usbharu/HomeCockpit/firmware/upper_panel_ddi/README.md

# upper_panel_ddi firmware

`upper_panel_ddi` は Upper Panel DDI 向けのファームウェアです。Cargo feature で MCU を選びます。

| Feature（default） | MCU | Rust target |
| --- | --- | --- |
| `rp2040`（default） | RP2040（Pico など） | `thumbv6m-none-eabi` |
| `rp235x` | RP235x（Pico 2 など） | `thumbv8m.main-none-eabihf` |

Cargo のデバッグ runner には `probe-rs run` を使用します。`.cargo/config.toml` で target ごとに chip を切り替えています。

## 必要なツール

- Rust toolchain
- 対象 MCU に応じた Rust target（RP2040: `thumbv6m-none-eabi`、RP235x: `thumbv8m.main-none-eabihf`）
- `probe-rs`（`probe-rs-tools`）
- 対象ボードに接続した SWD 対応の Debug Probe

`probe-rs` は [公式インストール手順](https://probe.rs/docs/getting-started/installation/)
に従ってインストールし、`probe-rs` コマンドが `PATH` に含まれていることを確認してください。

```powershell
rustup target add thumbv6m-none-eabi
rustup target add thumbv8m.main-none-eabihf
probe-rs --version
```

## Probe とターゲットの確認

RP2040:

```powershell
probe-rs list
probe-rs info --chip RP2040 --protocol swd
```

RP235x:

```powershell
probe-rs list
probe-rs info --chip RP235x --protocol swd
```

`probe-rs list` に Debug Probe が表示され、`probe-rs info` が対象 chip に接続できれば、
書き込みの準備は完了です。複数の Probe を接続している場合は、必要に応じて
`--probe VID:PID[:SERIAL]` をコマンドへ追加してください。runner の設定には特定の
Probe ID を固定していません。

## ビルドと実行

### RP2040（default）

```powershell
cd C:\Users\haruj\Documents\HomeCockpit\firmware\upper_panel_ddi
cargo build --locked --bin upper_panel_ddi
cargo run --locked --bin upper_panel_ddi
```

`.cargo/config.toml` の `thumbv6m-none-eabi` runner は `probe-rs run --chip RP2040` です。

### RP235x

default feature を外し、`rp235x` と target を明示します。

```powershell
cd C:\Users\haruj\Documents\HomeCockpit\firmware\upper_panel_ddi
cargo build --locked --no-default-features --features rp235x --target thumbv8m.main-none-eabihf --bin upper_panel_ddi
cargo run --locked --no-default-features --features rp235x --target thumbv8m.main-none-eabihf --bin upper_panel_ddi
```

`thumbv8m.main-none-eabihf` の runner は `probe-rs run --chip RP235x`（`--protocol swd --connect-under-reset`）です。

`cargo run` は `probe-rs run` によってファームウェアを書き込み、ターゲットを
リセットして実行します。`defmt-rtt` の RTT/defmt ログは同じコンソールへ出力されます。
ログレベルは `.cargo/config.toml` の `DEFMT_LOG = "debug"` で設定されています。

## panic と HardFault の診断

`panic-probe` と `defmt-rtt` をリンクしているため、panic 発生時の情報は
`probe-rs run` のコンソールで確認できます。HardFault の診断時は、ビルド済み ELF を
直接実行してスタックトレースを常に表示できます。

```powershell
probe-rs run --chip RP2040 --always-print-stacktrace `
  target\thumbv6m-none-eabi\debug\upper_panel_ddi
```

通常の開発では `cargo run --locked --bin upper_panel_ddi` を使用してください。

## IMCP 通信の確認

この crate は USB CDC 接続中は USB CDC（Windows では COM ポート）を、USB CDC が
接続されていない場合は UART を IMCP transport として使用します。どちらも
115200 baud の IMCP 通信です。ファームウェア実行後、既存の IMCP ホストを接続して、
次の動作を確認します。

1. デバイスから JOIN が送信される。
2. アドレス割り当てを受信する。
3. ACK が返る。
4. ボタン操作で制御イベントが送信される。
5. USB CDC または UART 経由の通信が継続する。

Manager などのホストから HCP の `RequestDeviceHello` を受信した場合、デバイスは
現在の IMCP address から `DeviceHello` を再送します。これにより、デバイスが既に
`Ready` 状態で起動した Manager に接続された場合も再発見できます。
表示 Data の適用とこの再送は、送信元が IMCP マスター `0x01` のフレームだけです。
直接接続には送信元を書き換えるハブがないためです。
送信キューには ACK と `DeviceHello` 用の 2 枠を予約しており、通常のボタンイベントが
この予約枠を消費しないようにしています。Manager 側も取りこぼしに備え、100ms 間隔で
最大 4 回（初回を含む）`RequestDeviceHello` を送信します。

## Hardening の再現可能な検証

受信経路には、IMCP の最大フレームを考慮した固定長バッファ、同一 read に含まれる複数
フレームの drain、受信バッファ溢れ後の SOF 再同期、再接続時の送信キュー破棄を実装して
います。ACK/Pong は専用の 2 スロットの送信キューから優先送信します。通常の button
event は、`DeviceHello` 用の 2 スロットをアプリケーション送信キューに残して追加します。
USB write endpoint の異常時は UART へフォールバックし、実際の USB 切断を確認してから
USB への再接続を試みます。

ホスト側の IMCP 回帰テストとフォーマットは次で確認できます。

```powershell
cd C:\Users\haruj\Documents\HomeCockpit\imcp
cargo test --locked --workspace
cargo fmt --all -- --check
cargo clippy --locked --workspace --lib --bins -- -D warnings
```

ファームウェアの CI と同じ検証は、サブモジュールを初期化したチェックアウトで次を実行
します。

```powershell
cd C:\Users\haruj\Documents\HomeCockpit\firmware\upper_panel_ddi
cargo build --locked --release --target thumbv6m-none-eabi --bin upper_panel_ddi
cargo fmt --all -- --check
cargo clippy --locked --target thumbv6m-none-eabi --bin upper_panel_ddi -- -D warnings
```

RP235x（CI と同じコマンド）:

```powershell
$env:RUSTFLAGS = '-C target-cpu=cortex-m33'
cargo build --locked --release --no-default-features --features rp235x --target thumbv8m.main-none-eabihf --bin upper_panel_ddi
cargo clippy --locked --no-default-features --features rp235x --target thumbv8m.main-none-eabihf --bin upper_panel_ddi -- -D warnings
```

stack watermark はまだ導入していないため、実行時の watermark を確認済みとは扱いません。
代わりに release ELF の linker map を生成して、静的 RAM 使用量と linker が予約する stack
領域を確認できます。

```powershell
$env:RUSTC_WRAPPER = ''
$env:RUSTFLAGS = '-C link-arg=-Map=C:\temp\upper_panel_ddi.map'
cargo build --locked --release --target thumbv6m-none-eabi --bin upper_panel_ddi
Select-String -Path C:\temp\upper_panel_ddi.map -Pattern '_stack_start|_stack_end|\.bss|\.data|\.uninit'
```

map の確認は stack overflow が発生しないことの証明ではありません。実機の長時間確認では、
`probe-rs run --always-print-stacktrace` の RTT/defmt 出力を採取し、USB CDC の再接続、
JOIN/SetAddress/ACK、`DeviceHello`、button event の順に観測してください。

## `probe-run` からの移行

以前の runner は `probe-run --chip RP2040` でした。`probe-run` はメンテナンスモードの
ため、現在は後継の `probe-rs run --chip RP2040` を使用します。runner では Probe ID、
接続速度、`--connect-under-reset` を固定せず、接続環境に応じた指定をコマンドラインから
追加できるようにしています。
