usbharu/HomeCockpit/upper_panel_ddi/mechanical/case/upper_panel_ddi_case.dxf

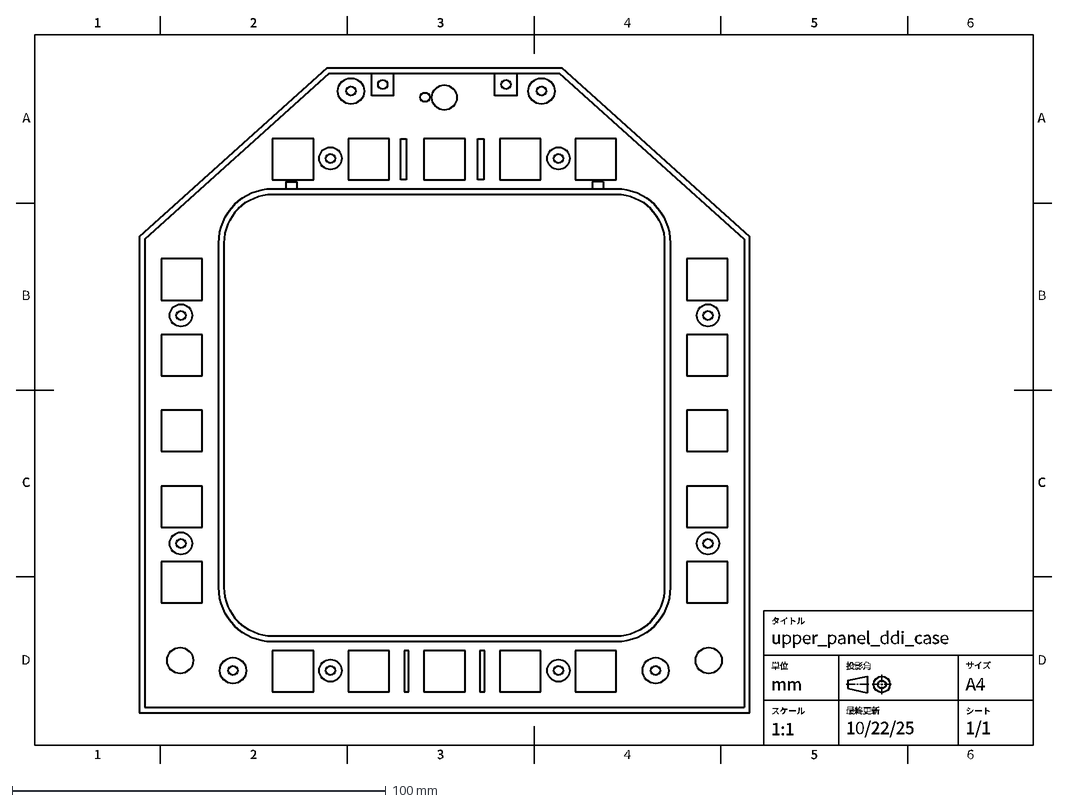
[picture p2: CAD file, 2025-10-22]
upper_panel_ddi/mechanical/case/upper_panel_ddi_case.dxf
1
2
3
4
5
6
D
C
B
A
10/22/25
タイトル
upper_panel_ddi_case
単位
mm
スケール
投影角
サイズ
A4
1:1
最終更新
シート
1/1
