usbharu/HomeCockpit/upper_panel_ddi/pcb/button_panel/upper_panel_ddi_button_panel.dxf

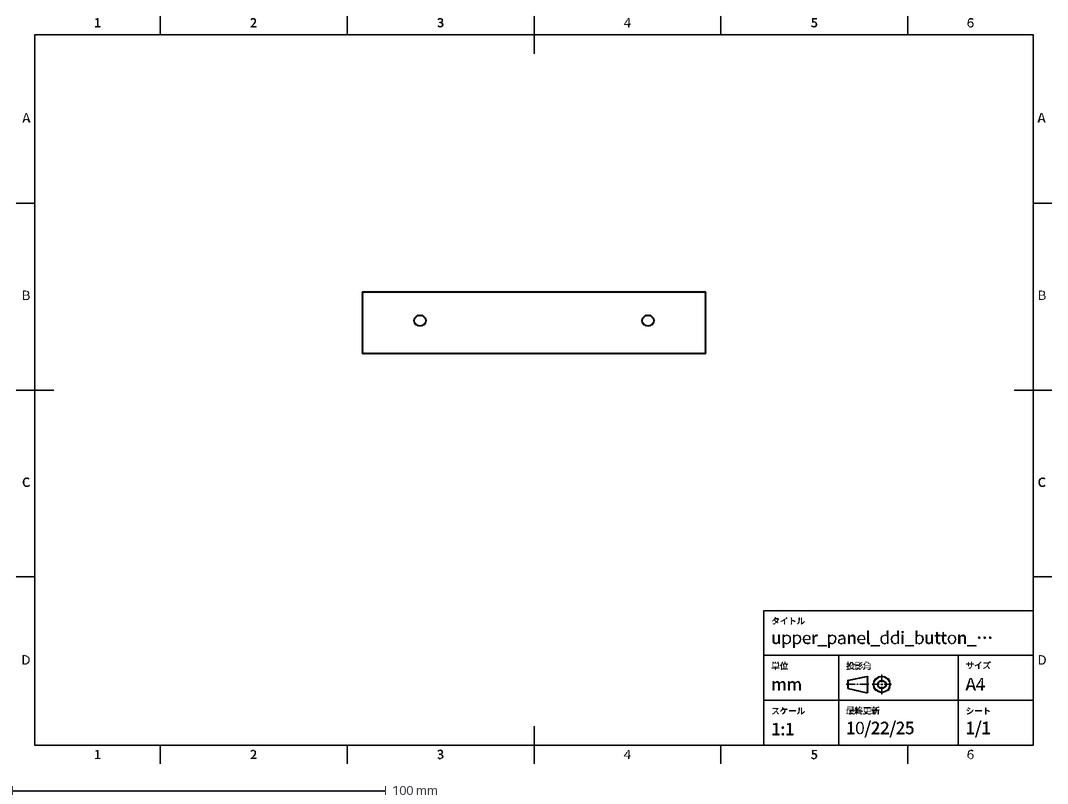
[picture p3: CAD file, 2025-10-22]
upper_panel_ddi/pcb/button_panel/upper_panel_ddi_button_panel.dxf
1
2
3
4
5
6
D
C
B
A
10/22/25
タイトル
upper_panel_ddi_button_…
単位
mm
スケール
投影角
サイズ
A4
1:1
最終更新
シート
1/1
