usbharu/HomeCockpit/upper_panel_ddi/pcb/button_panel/upper_panel_ddi_button_panel.kicad_pcb

## KiCad design upper_panel_ddi/pcb/button_panel/upper_panel_ddi_button_panel.kicad_pcb (2026-09-18)

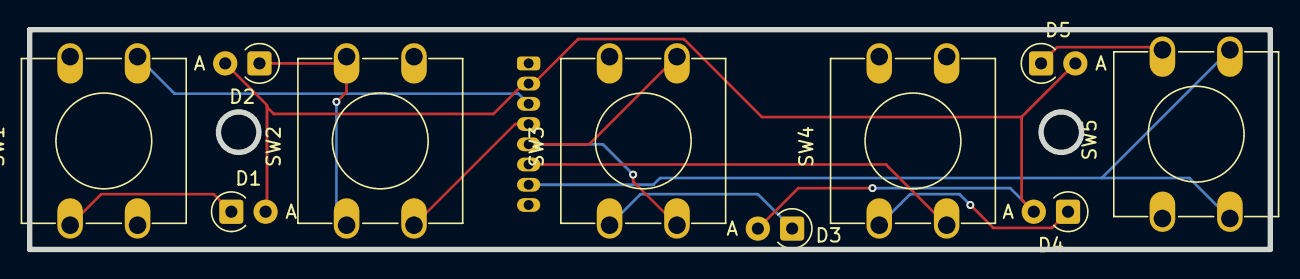
[picture p4: board upper_panel_ddi_button_panel.kicad_pcb from above]

Board: 2 copper layers, 92.0 x 16.3 mm, 11 parts (1 on the bottom side), 11 nets.

Parts:
D1, D2, D3, D4, D5: D; D_A-405_P2.54mm_Vertical_AnodeUp
J1: Conn_01x08_Pin; JST_ZH_B8B-ZR_1x08_P1.50mm_Vertical
SW1, SW2, SW3, SW4, SW5: SW_Push; SW_PUSH-12mm-mini

Connections:
unnamed: D1.2 (A), D2.2 (A), D3.2 (A), D4.2 (A), D5.2 (A), J1.2
unnamed: D1.1 (K), SW1.1
unnamed: D2.1 (K), SW2.1
unnamed: D3.1 (K), SW3.1
unnamed: D4.1 (K), SW4.1
unnamed: D5.1 (K), SW5.1
unnamed: J1.3, SW1.2
unnamed: J1.4, SW2.2
unnamed: J1.5, SW3.2
unnamed: J1.6, SW4.2
unnamed: J1.7, SW5.2
