usbharu/HomeCockpit/firmware/upper_panel_ddi/build.rs

//! This build script copies the `memory.x` file from the crate root into
//! a directory where the linker can always find it at build time.
//! For many projects this is optional, as the linker always searches the
//! project root directory -- wherever `Cargo.toml` is. However, if you
//! are using a workspace or have a more complicated build setup, this
//! build script becomes required. Additionally, by requesting that
//! Cargo re-run the build script whenever `memory.x` is changed,
//! updating `memory.x` ensures a rebuild of the application with the
//! new memory settings.

use std::env;
use std::fs::File;
use std::io::Write;
use std::path::PathBuf;

fn main() -> Result<(), Box<dyn std::error::Error>> {
    let rp235x = env::var("CARGO_FEATURE_RP235X").is_ok();
    let memory_x: &[u8] = if rp235x {
        include_bytes!("memory-rp235x.x")
    } else {
        include_bytes!("memory.x")
    };

    // Put `memory.x` in our output directory and ensure it's
    // on the linker search path.
    let out = PathBuf::from(env::var_os("OUT_DIR").ok_or("OUT_DIR is not set")?);
    File::create(out.join("memory.x")).and_then(|mut file| file.write_all(memory_x))?;
    println!("cargo:rustc-link-search={}", out.display());

    // By default, Cargo will re-run a build script whenever
    // any file in the project changes. By specifying `memory.x`
    // here, we ensure the build script is only re-run when
    // `memory.x` is changed.
    println!("cargo:rerun-if-changed=memory.x");
    println!("cargo:rerun-if-changed=memory-rp235x.x");
    println!("cargo:rerun-if-changed=build.rs");

    println!("cargo:rustc-link-arg-bins=--nmagic");
    println!("cargo:rustc-link-arg-bins=-Tlink.x");
    if !rp235x {
        println!("cargo:rustc-link-arg-bins=-Tlink-rp.x");
    }
    println!("cargo:rustc-link-arg-bins=-Tdefmt.x");

    Ok(())
}
