usbharu/HomeCockpit/(commit log)

2025-10-19 refactor(imcp): ファイルを分割
2025-10-22 kicad: upper_panel_ddi_button_panelの設計を追加
    [upper_panel_ddi_button_panel.dxf, upper_panel_ddi_button_panel.kicad_pcb, upper_panel_ddi_button_panel.kicad_sch, upper_panel_ddi_case.dxf]
2025-10-22 wip(imcp): Master/Clientを生成できるように
2025-10-23 feat(imcp): ClientでSetAddressが動作するように
2025-10-23 feat(imcp): クライアントにNotReadyの状態を追加
2025-10-23 fix(imcp): ペイロードにSOFバイトが来た際に正常に動作しない問題を修正
2025-10-23 chore: VSCodeですべてのプロジェクトを読み込むように
2025-10-23 fix(imcp): エンコード処理が抜け落ちていたので追加
2025-10-24 feat(imcp): MasterのStateを追加
2025-10-25 kicad: upper_panel_ddiを追加
    [upper_panel_ddi.kicad_pcb, upper_panel_ddi.kicad_sch]
2025-10-25 wip(firmware): 組み込み開発の構成を追加
2025-10-26 kicad: AE-RP2040のシンボルとフットプリントを追加
    [upper_panel_ddi.kicad_sch]
2025-10-30 wip(imcp): 送るFrameをキューに保持できる準備
2025-10-30 wip(imcp): embassyへの依存を切り離した
2025-10-30 feat(imcp): 送信を追加
2025-11-01 feat(imcp): embassyで動作するように
2025-11-01 chore: VSCodeのスペルチェッカーにスペルを追加
2025-11-01 feat(imcp): ログを追加
2025-11-01 feat(firmware): ddiのキーマトリクスが動作するように
2025-11-01 kicad: upper_panel_ddiを更新
    IOエキスパンダを使わずRaspberry PI Picoを直接使うように
    [upper_panel_ddi.kicad_pcb, upper_panel_ddi.kicad_sch]
2025-11-03 refactor(imcp): 危険なunwrapを無くした
2025-11-03 chore: スペルチェッカーに単語を追加
2025-11-04 feat(imcp): キャリアセンスを追加
2025-11-05 feat(imcp): defmt対応
2025-11-05 feat(firmware): imcpが動作するように
2025-11-07 feat(imcp): imcp-tokioを追加
2025-11-07 feat(utils): imcp-cliを追加
2025-11-07 feat(utils): imcp-cliにunpackとwatchを追加
    unpackは標準入力とオプションからhexを読み取り、パースして表示します。watchはシリアルポートを監視してunpackと同等の内容を実行します。
2025-11-07 fix(imcp): imcp-embeddedでバイト列が完全に送信できてない場合がある問題を修正
    write_allを使用していなかったため送信できていないデータがあった
    writeの使用箇所をwrite_allに変更して修正
    [lib.rs]
2025-11-07 fix(firmware): flushできてなかったので修正
2025-11-07 feat(utils): logを追加
2026-04-01 Add HCP firmware base and unique device identity handling
2026-04-01 Detect IMCP/HCP devices in the manager settings tab
2026-04-02 feat(manager): update IMCP device discovery to return device count and scanned ports
2026-04-02 Add dcs-bios-rs crate and fix its dependencies
    [lib.rs]
2026-04-02 Add DeviceRole-based DCS-BIOS mapping to manager
2026-09-11 fix(imcp): harden protocol framing and addressing
    [lib.rs]
2026-09-11 feat(firmware): add Pico 2 bring-up projects
2026-09-11 fix(imcp): tolerate duplicate address assignment acknowledgements
    [lib.rs]
2026-09-11 debug(firmware): log upper panel UART receive data
2026-09-12 test(imcp): add POSIX PTY wire E2E coverage (#26)
2026-09-12 Issue #28: 変更箇所に応じた並列 CI (#33)
    * ci: add path-aware GitHub Actions checks
    * test: add host smoke tests for empty test targets
    * chore(ci): fix existing CI failures
    * fix(ci): support GitHub runner native dependencies
    * ci: limit workflow to pull requests targeting master
    * ci: render KiCad violations on board images
    * fix(ci): use KiCad report coordinates for overlays
    * ci: comment KiCad violations on failed checks
    * ci: embed KiCad images in PR comments
    * fix(ci): align KiCad violation overlays
    * fix(ci): run checks when CI scripts change
    [build.rs, lib.rs, main.rs]
2026-09-12 fix(firmware): migrate upper panel runner to probe-rs (#38)
    * feat(firmware): add Pico 2 bring-up projects
    * fix(firmware): migrate upper panel runner to probe-rs
    [build.rs, main.rs]
2026-09-12 上部パネルDDIのUSB-CDC対応 (#34)
    * feat(firmware): add USB CDC IMCP transport
    * style(imcp): format restart test
    * fix(firmware): satisfy upper panel clippy
    [lib.rs, main.rs, packetization.rs, transport.rs]
2026-09-12 Raspberry Pi Pico向けRust書き込み・実機検証スキルを追加 (#40)
    * feat(skills): Raspberry Pi PicoのRust検証スキルを追加
    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
2026-09-12 DCS-BIOS接続デバッグ用スキルを追加 (#41)
    * docs(dcs-bios): add connection debugging skill
    * chore(skills): move Pico probe skill to agents
2026-09-12 IMCPプロトコル解析用SKILLを追加 (#43)
    docs(skills): add IMCP protocol skill
2026-09-12 IMCP-CLIにLLM向けmasterデバッグモードを追加 (#42)
    * feat(utils): add IMCP master debug mode
    * fix(utils): drive master retries and outbound sends
    * fix(utils): complete master debug I/O handling
    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
    [main.rs]
2026-09-12 docs: エージェント向けデバッグガイドを改善 (#44)
    docs: improve agent debugging guidance
2026-09-12 IMCP-CLIデバッグスキルを追加 (#47)
    feat(utils): add imcp-cli debugging skill
2026-09-15 feat(manager): implement role and adapter mapping pipeline (#49)
    * feat(manager): implement role and adapter mapping pipeline
    * fix(manager): load DCS-BIOS mappings from control references
    * fix(manager): make adapter catalogs self-contained
    * fix(manager): prevent mapping selection update loop
    * feat(manager): move adapter profiles out of mapping screen
    [lib.rs, main.rs]
2026-09-15 feat(utils): add upper panel DDI mock (#50)
    * feat(utils): add upper panel DDI mock
    * fix(manager): serialize endpoint startup discovery
    * fix(manager): reassemble DCS aircraft names
    * fix(manager): deduplicate realtime logs
    * feat(manager): edit role IO mappings inline
    * fix(manager): persist DCS command destination
    * fix(manager): release momentary DDI buttons
    * fix(manager): pulse DDI button pushed actions
    * feat(manager): trigger mappings through role actions
    * refactor(manager): unify role control mapping UI
    [lib.rs, main.rs, pty.rs]
2026-09-15 fix(manager): IMCPデバイスの自動再接続と再発見 (#56)
    fix(manager): recover IMCP devices without reload
    [lib.rs, main.rs]
2026-09-17 chore(rust): align embedded dependency updates (#102)
    * chore(rust): align embedded dependency updates
    * fix(upper-panel): adapt USB error handling to embassy-usb 0.6
    * fix(upper-panel): remove obsolete USB read error state
    [main.rs, transport.rs]
2026-09-17 refactor(hardware): reorganize upper panel ddi assets (#105)
    [upper_panel_ddi.kicad_pcb, upper_panel_ddi.kicad_sch, upper_panel_ddi_button_panel.dxf, upper_panel_ddi_button_panel.kicad_pcb, upper_panel_ddi_button_panel.kicad_sch, upper_panel_ddi_case.dxf]
2026-09-17 chore(hardware): remove obsolete upper panel ddi KiCad project (#108)
    chore(hardware): remove obsolete upper panel ddi project
    [upper_panel_ddi.kicad_pcb, upper_panel_ddi.kicad_sch]
2026-09-17 fix(hardware): resolve button panel missing connections (#109)
    fix(hardware): model button switch internal connections
    [upper_panel_ddi_button_panel.kicad_pcb, upper_panel_ddi_button_panel.kicad_sch]
2026-09-18 未登録ボタンを順番に連続学習できるUIを追加しました (#114)
    * feat(manager): add continuous button learning
    * fix(manager): preserve continuous learn state and events
2026-09-18 chore(kicad): KiCad 10へプロジェクトを移行 (#113)
    chore(kicad): migrate projects to KiCad 10
    [upper_panel_ddi_button_panel.kicad_pcb, upper_panel_ddi_button_panel.kicad_sch]
2026-09-22 fix(manager): IMCP再接続時の旧アドレス残留を修正 (#60)
    fix(manager): reconcile IMCP addresses on reconnect
    [lib.rs]
2026-09-23 fix(manager): Hub 配下デバイスの再発見を修正 (#62)
    * fix(manager): correlate hub child rediscovery
    * fix(manager): bound hub child discovery correlation
    * fix(manager): correlate hub child rediscovery
    * fix(manager): bound hub child discovery correlation
    * fix(manager): harden hub discovery correlation
    * fix(manager): harden repeated hub rediscovery
    * fix(manager): make hub rediscovery correlation conservative
    [lib.rs]
2026-09-23 fix(imcp): DeviceHello と Upper Panel の通信停止を修正 (#63)
    * fix(imcp): prevent DeviceHello queue drops
    * fix(mock): preserve control event sequence on queue full
    * test(mock): acknowledge DeviceHello before next event
    * fix(upper-panel): harden IMCP liveness and recovery
    * fix(firmware): use shared queue capacity after PR integration
    * fix(upper-panel): preserve reads while response queue drains
    * fix(manager): stop root DeviceHello retry after response
    * fix(upper-panel): prioritize protocol replies and recover USB faults
    * docs(upper-panel): describe priority protocol responses
    [lib.rs, main.rs, packetization.rs, transport.rs]
2026-09-23 fix(imcp-cli): keep master responses flowing during Set retries (#120)
    [lib.rs, main.rs]
2026-09-25 fix(manager): 非選択タブの画面を隠す (#124)
    fix(manager): hide inactive tab content
2026-09-27 feat(manager): 応答する COM ポートを接続候補に表示 (#133)
    * feat(manager): scan responsive serial ports for connection suggestions
    * fix(manager): hide registered serial port candidates
    [lib.rs]
2026-09-27 feat(manager): 選択したRoleの結線を一括削除できるようにする (#136)
    * feat(manager): 選択したRoleの結線を一括削除できるようにする
    * fix(manager): 一括削除後に学習完了状態を解除する
2026-09-27 fix(manager): 連続学習完了後にRoleを切り替えられるようにする (#137)
    fix(manager): allow role switching after continuous learn completes
2026-09-27 feat(manager): 既存結線をクリアして連続学習を開始する (#138)
    * feat(manager): allow relearning after clearing device bindings
    * fix(manager): lock role selection during continuous learn reset
    Prevent switching roles while clearing bindings so saved mappings match the UI.
    ---------
2026-09-27 chore(manager): pnpm に統一し npm install をブロック (#139)
    chore(manager): unify on pnpm and block npm installs
    Remove package-lock.json, wire Tauri and CI to pnpm 12.6.0, and reject accidental npm lockfiles in CI.
2026-09-28 docs(imcp): IMCP CLIデバッグスキルを.agentsへ移動 (#141)
    docs(imcp): move CLI debugging skill to agents directory
2026-10-01 chore(deps): update dependency next to v16.3.7 (#121)
    Rebased onto current master after other Renovate merges.
2026-10-03 feat(manager): MCP サーバーと診断 Tool を追加 (#143)
    * feat(manager): MCP サーバーと診断 Tool を追加
    * feat(manager): tune MCP tool descriptions with live call harness
    Align tool and server instructions with observed handlers, add manager-mcp-serve
    and scripts to call all tools against a live server for agent-driven tuning.
    * fix(manager): address Codex PR review for MCP and endpoints
    Cancel stale endpoint writes after confirmation timeout, reject duplicate
    endpoint IDs, and expose only DCS-BIOS bytes that were actually received.
    * fix(manager): satisfy Clippy in backend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
    [lib.rs]
2026-10-03 chore(deps): update dependency next to v16.3.8 (#146)
    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
2026-10-03 chore(firmware): add RP235x CI and bump embassy submodule (#151)
    * chore(firmware): add RP235x CI and bump embassy submodule
    Update the vendored embassy gitlink and adapt upper_panel_ddi and imcp-embedded
    for embassy-rp API changes, with a dedicated CI job that builds and runs Clippy
    for the rp235x feature on thumbv8m.main-none-eabihf.
    * docs(firmware): add RP235x probe-rs runner and build docs
    Use target-specific cargo runners so rp235x builds invoke probe-rs with RP235x,
    and document feature, target, and CI-equivalent commands in the README.
    ---------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
2026-10-04 feat(ci): KiCad変更前後の画像をPRコメントに表示 (#156)
    * feat(ci): add KiCad PR change previews
    * fix(ci): publish KiCad previews from trusted workflow
2026-10-04 fix(ci): KiCad画像コメント投稿のPR書き込み権限を修正 (#157)
    fix(ci): grant KiCad publisher PR comment permission
2026-10-04 feat(hardware): Upper Panel main_board schematic (firmware-aligned) (#152)
    * feat(hardware): add Upper Panel main_board schematic (firmware-aligned)
    Restore main_board as schematic-only KiCad 10 project with generator-driven
    wiring for Pico matrix, power, and panel connectors; enforce ERC in CI.
    * chore(ci): extend main_board KiCad checks in workflow
    Trigger kicad-main-board on firmware/upper_panel_ddi changes, verify
    generate_schematic.py output before ERC, and use deterministic sch UUIDs.
    * fix(ci): align KiCad PR previews with main_board symbol resolution
    Set KICAD10_SYMBOL_DIR and KIPRJ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
    [upper_panel_ddi_main_board.kicad_sch]
2026-10-10 refactor(manager): reorganize tab IA and HelpTip state hints (#164)
    * refactor(manager): focus log tab on events with compact DCS summary
    Replace duplicate metric cards with a one-line DCS-BIOS summary and steer detailed connection diagnostics to the software tab.
    * refactor(manager): align adapter tab role navigation with mapping
    Replace the standalone Role dropdown with a sidebar role list so I/O mapping stays in context with the selected role.
    * refactor(manager): split device role assignment from status cards
    Add a dedicated Role assignment section and collapse technical device fields b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
2026-10-10 fix(firmware): apply display updates and DeviceHello only from the IMCP master (#177)
    Direct connections have no hub rewriting the source address, so a station other than 0x01 could advance the display sequence and elicit a DeviceHello.
    Fixes #173
    [lib.rs, main.rs]
2026-10-10 test(protocol): check IMCP and firmware logic with properties and proofs (#178)
    * test(protocol): check IMCP and firmware logic with properties and proofs
    Host tests did not reach frame recovery, sequence boundaries, or USB packet splits, so surviving mutants could not be separated from equivalent ones.
    * test(imcp): resync after a real payload-length mismatch
    The broken frame ended at an unescaped EOF, so the declared length never reached the decoder.
    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
    [lib.rs, packetization.rs]
